dochoacruz/Proyecto-G2-EDP-R5053-2025/Proyecto 1C/Informe-IEEE.docx

Fuente Regulada Buck

Ochoa Cruz David¹, Calero Costa Diego Andrés²

Facultad Regional Buenos Aires, Universidad Tecnológica Nacional

¹Dochoacruz@frba.utn.edu.ar

²diegocale@frba.utn.edu.ar

Grupo 2

Abstract— En el marco de la asignatura Electrónica de Potencia, este proyecto se centra en el desarrollo completo de una fuente conmutada tipo Buck (reductor), orientada a convertir una tensión continua de entrada de 12V a una salida regulada de 5V. El diseño se basó en el uso del circuito integrado MC34063A, un controlador clásico por su simpleza, bajo costo y facilidad de implementación. A lo largo del trabajo se combinaron aspectos teóricos y prácticos, desde el análisis del funcionamiento de la topología Buck y el cálculo de los componentes claves (Inductor, Capacitor, Diodo, y resistencias), hasta la simulación del circuito en LTSpice para Evaluar su desempeño.

Posteriormente, se llevó a cabo el diseño del esquemático y del PCB utilizando herramienta CAD (KiCad), seguido de la construcción de un prototipo funcional que permitió comprobar el comportamiento real del sistema. Las pruebas experimentales permitieron validar la regulación de la tensión de salida y el correcto funcionamiento del regulador bajo distintas condiciones de carga.

En conclusión, el proyecto demuestra que es posible diseñar una fuente conmutada compacta, eficiente y confiable con recursos accesibles, integrando herramientas de simulación y diseño para lograr resultados consistentes entre la teoría y la práctica.

Palabras claves: Buck, MC34063A, conmutada, fuente conmutada. diseño

I. Introduction

En la actualidad, la eficiencia energética y la miniaturización de dispositivos electrónicos han impulsado el uso generalizado de las fuentes de alimentación conmutadas (Switch Mode Power Supplies) en una gama de aplicaciones, desde cargadores de dispositivos móviles hasta sistemas industriales y de telecomunicaciones. A diferencia de las fuentes lineales, que regulan la tensión mediante la disipación de potencia en elementos resistivos o activos que trabajan en la zona activa, las fuentes conmutadas utilizan llaves electrónicas de conmutación, como transistores, que trabajan en la zona de corte y saturación, disipando la mínima potencia, por lo que son muy eficientes.

Estas fuentes funcionan mediante la conmutación rápida de un interruptor electrónico (MOSFET, IGBT, etc.) que controlan el flujo de energía a través de componentes reactivos como inductores y capacitores, permitiendo almacenar y transferir energía de forma controlada. Esto los hace mucho más eficientes, logrando obtener fuentes de alimentación compactas, ligeras.

Existen diversas topologías de fuentes conmutadas, como los reguladores: Buck (reductor), Boost (elevador), Buck-Boost e incluso diseños más complejos como los convertidores Flyback y Forward, cada uno con sus propias ventajas.

El presente trabajo tiene como objetivo el diseño y desarrollo de una fuente conmutada tipo Buck, partiendo del análisis teórico y el cálculo de sus componentes, seguido de la simulación del circuito para validar su comportamiento. Posteriormente, se llevará a cabo la implementación física del prototipo, contrastando los resultados experimentales con los obtenidos en la etapa de simulación y diseño, con el fin de verificar el correcto funcionamiento y desempeño de la fuente.

II. Principio de funcionamiento

El regulador Buck es una topología de fuente conmutada reductora, es decir, a partir de una tensión de entrada, se obtiene un nivel de tensión inferior. Su funcionamiento se basa en el almacenamiento de energía en elementos reactivos, mediante un interruptor electrónico (generalmente un MOSFET), un diodo, un inductor y un capacitor, que juntos conforma un circuito de conversión reductor.

:

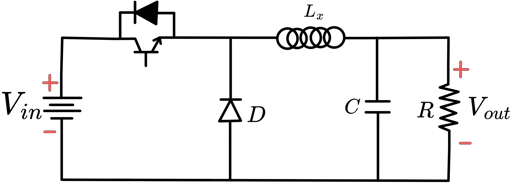
[picture p3: figure]

El principio de funcionamiento se puede dividir en dos fases diferentes durante un ciclo de conmutación completa:

ON (Interruptor cerrado): Cuando el interruptor está cerrado, el inductor comienza a almacenar energía en forma de campo magnético, mientras que la corriente aumenta linealmente. Durante este tiempo el diodo se encuentra polarizado en inversa (bloqueado). Inicialmente el capacitor es quién se encarga de entregar toda la corriente a la carga. Sin embargo, a medida que la corriente en el inductor incrementa, este empieza también a entregar corriente a la carga, compartiendo gradualmente la demanda con el capacitor hasta convertirse en la fuente principal de corriente durante esta fase.

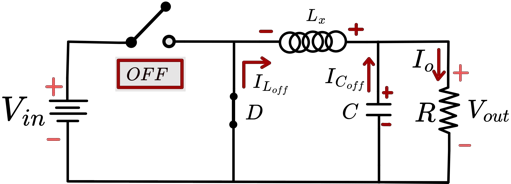
[picture p4: figure]

OFF (Interruptor abierto): Cuando el interruptor está se abre, el inductor se opone al cambio abrupto de la corriente, invirtiendo su polaridad. Esta corriente ahora fluye a través del diodo, que queda polarizado en directa, hacia la carga y el capacitor, manteniendo la entrega de energía. En esta fase, la corriente a través del inductor disminuye progresivamente. Para mantener la corriente constante en la carga, el capacitor es quién gradualmente repone lo que dejo de entregar el inductor, hasta que se convierte en la fuente principal de corriente durante esta fase.

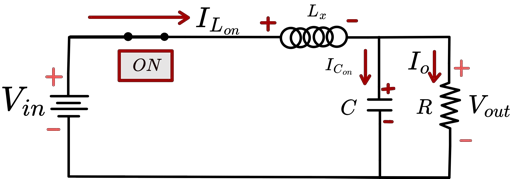
[picture p5: figure]

Este ciclo se repite a una frecuencia de conmutación f (típicamente entre las decenas de kHz hasta varios MHz), generando una tensión de salida regulada inferior a la entrada. La relación entre la tensión de entrada () y la tensión de salida () depende del ciclo de trabajo del interruptor, y en condiciones ideales se cumple que:

Donde es el ciclo de trabajo, definido como el cociente entre el tiempo en conducción y el periodo total del ciclo de conmutación.

III. Diseño teórico.
  A. Especificaciones de diseño

Parámetro | Símbolo | Valor | Unidad
Tension de Entrada | | 12 | V
Tension de Salida | | 5 | V
Corriente de Salida | | 0.2 – 1.0 | A
Frecuencia de conmutación | | 40 | kHz
Rizado de tension | | | mV

  B. Características principales del mc34063A

Parámetro | Símbolo | Valor | Unidad
Tensión de Entrada | | 12 | V
Tensión de Salida | | 5 | V
Corriente de Salida | | 0.2 – 1.0 | A
Frecuencia de conmutación | | 40 | kHz
Rizado de tensión | | | mV

  C. Ecuaciones fundamentales de diseño

Descripción | Step Dow
Razón de tiempos
Periodo
Tiempo de Apagado
Tiempo de Encendido
Capacidad de Timing
Corriente Pico
Resistencia de Sencing
Inductancia mínima
Capacidad de Salida
Tensión de Salida

  D. DISEÑÓ PROPUESTO

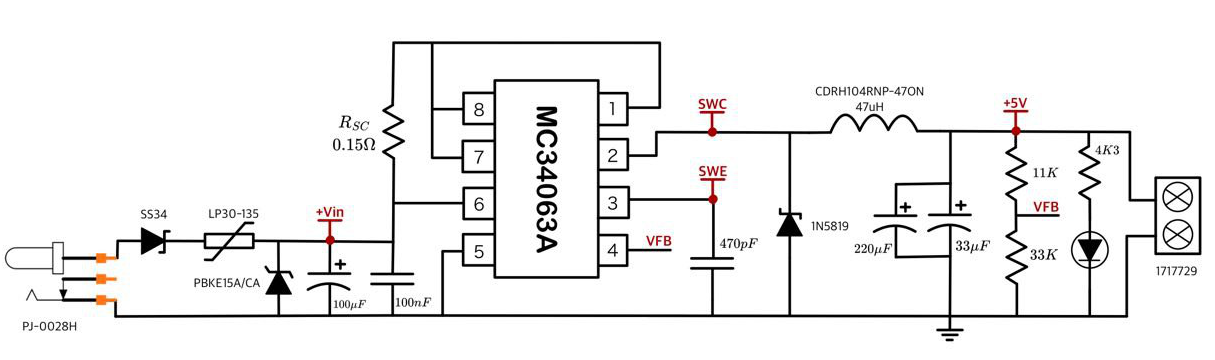
[picture p6: figure]

IV. Simulaciones

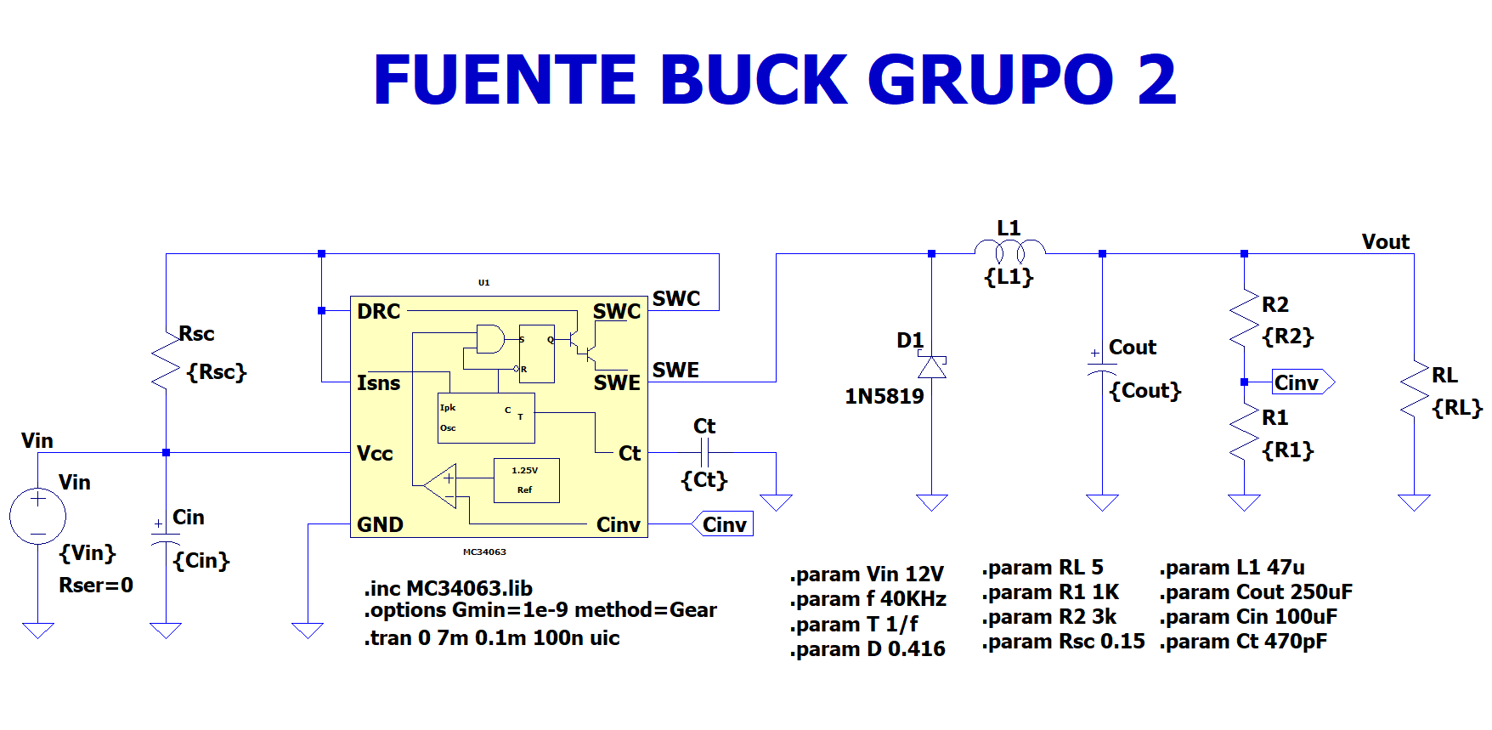
[picture p7: figure]
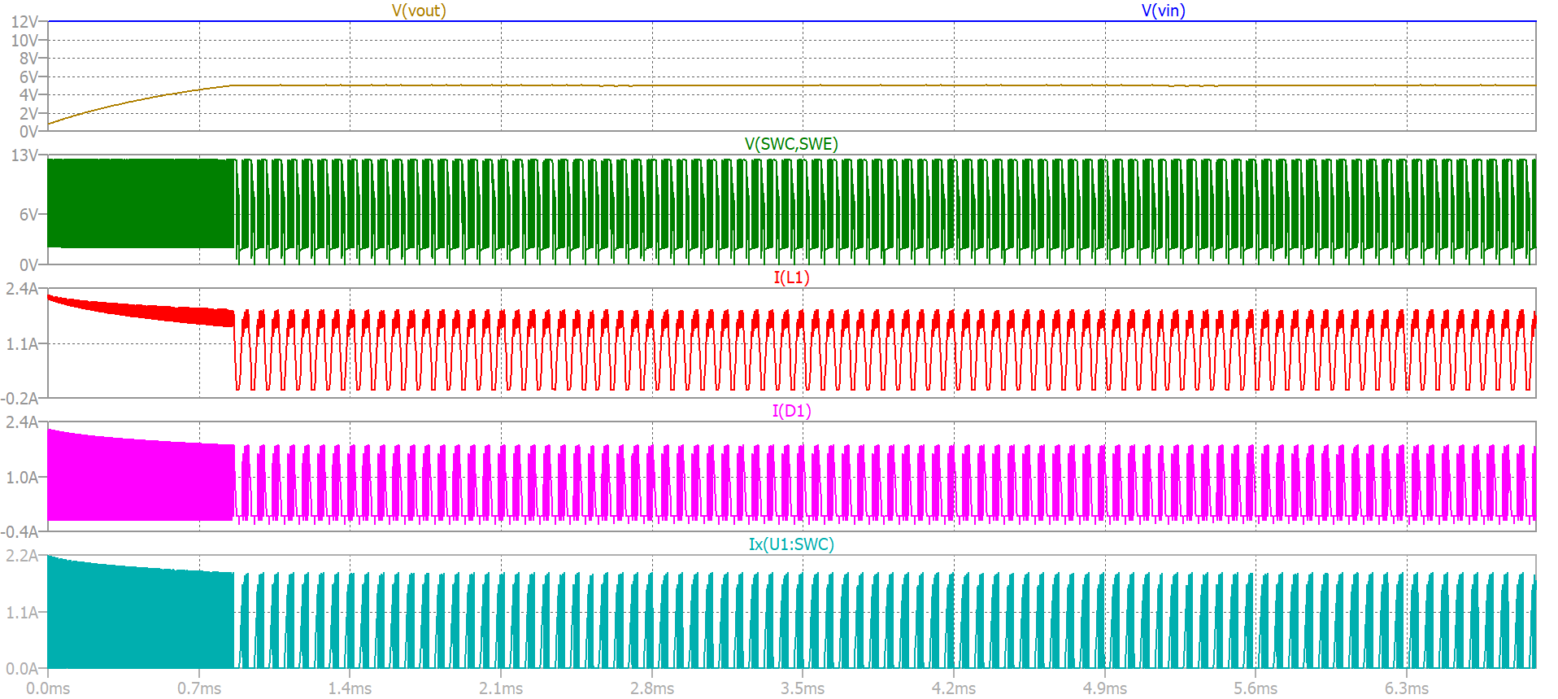
[picture p8: figure]

V. Mediciones de laboratorio
  A. CONDICIONES DE MEDICIÓN

Parámetro | Símbolo | Valor
Tensión de Alimentación
Resistencia de Carga

  B. INSTRUMENTTOS UTILIZADOS
- Fuente DC
- Osciloscopio
- Multímetro
  C. RESULTADOS DE LA MEDICIÓN

Parámetro | Símbolo | Valor
Tensión de Salida
Corriente de Salida
Ripple de Salida

VI. Conclusión

La realización de este proyecto resulto altamente didáctica, ya que permitió integrar y aplicar de manera efectiva los conocimientos teóricos y prácticos abordados en la cursada. Esto se vio reflejado especialmente en las pruebas experimentales, donde los resultados obtenidos fueron incluso mejores de lo esperado.

Durante el desarrollo se identificó la posibilidad de incorporar elementos de protección (como un poliswith y/o un diodo TVS), los cuales no se implementaron por cuestiones de tiempo. Siendo estas, mejoras para tener en cuenta en futuras versiones del proyecto.

Asimismo, el trabajo en equipo fue clave para alcanzar los objetivos, con una correcta división de tareas y colaboración constante entre los integrantes.

En definitiva, el proyecto no solo permitió cumplir con los objetivos académicos propuestos, sino que también despertó interés por seguir diseñando otras topologías de fuentes conmutadas, aplicando el mismo enfoque sistemático de análisis, diseño, simulación e implementación.

Referencias

[1] Hoja de datos del integrado: MC34063A - Inverting Regulator - Buck, Boost, Switching 1.5 A (https://www.onsemi.com/pdf/datasheet/mc34063a-d.pdf)
[2] Repositorio GitHub: Proyecto-G2-EDP-R5053-2025 (https://github.com/dochoacruz/Proyecto-G2-EDP-R5053-2025/blob/main/Proyecto%201C/Jupyter%20Notebook/Proyecto-G2.ipynb)
[3] Informe en formato cuaderno: Jupyter Notebook Viewer (https://nbviewer.org/github/dochoacruz/Proyecto-G2-EDP-R5053-2025/blob/main/Proyecto%201C/Jupyter%20Notebook/Proyecto-G2.ipynb)

[4] Video demostrativo: https://www.youtube.com/embed/OiL7ilHiBNU
