dochoacruz/Proyecto-G2-EDP-R5053-2025/Proyecto 1C/Informe.docx

UNIVERSIDAD TECNOLÓGICA NACIONAL FACULTAD REGIONAL BUENOS AIRES

Departamento de Electrónica

Fuente Regulada Buck

Materia: | Electrónica de Potencia
Curso: | R5052 - 2025
Docente: | Ing. Oscar Pugliese
Ayudante: | Diego Pirotta
Integrantes:

APELLIDO | NOMBRE | LEGAJO
Calero Costa | Diego | 1526066
Ochoa Cruz | David | 1638518

ÍNDICE

DICE

ABSTRACT

As part of the Power Electronics course, this project focused on the development of a Buck-type switched-mode power supply (step-down converter), designed to convert a 12V input voltage into a regulated 5V output. The design was based on the MC34063A integrated circuit, a widely used controller due to its simplicity, low cost, and ease of implementation.

The project encompassed both theoretical and practical aspects, including an analysis of the Buck converter's operating principle and the calculation of key components—inductor, capacitor, diode, and resistors—as well as circuit simulation using LTSpice to verify the theoretical results.

Subsequently, the schematic and printed circuit board (PCB) were designed using the KiCad CAD tool, followed by the construction of a functional prototype to assess the system’s real-world performance. Experimental measurements carried out with laboratory instruments validated the output voltage regulation and confirmed the proper operation of the converter under maximum load conditions.

In conclusion, the objectives defined at the outset of the project were successfully achieved, demonstrating the effective integration of the theoretical knowledge and practical skills developed throughout the course.

Keywords: Buck, MC34063A, switching, switching power supply, design.

RESUMEN

En el marco de la asignatura de Electrónica de Potencia, este proyecto se enfocó en el desarrollo de una fuente conmutada tipo Buck (reductor), con el objetivo de convertir una tensión de entrada de 12V, a una salida regulada de 5V. El diseño se basó en el uso del circuito integrado MC34063A, un controlador ampliamente utilizado por su simplicidad, bajo costo y facilidad de implementación.

A lo largo del trabajo se trataron tanto aspectos teóricos como prácticos: desde el análisis del principio de funcionamiento de la topología Buck y el cálculo de los componentes claves (Inductor, Capacitor, Diodo, y resistencias), hasta la simulación del circuito en LTSpice con el fin de validar los resultados obtenidos en los cálculos previos.

Posteriormente, se llevó a cabo el diseño del esquemático y del PCB utilizando herramienta CAD (KiCad), y se construyó un prototipo funcional que permitió comprobar el comportamiento real del sistema. Las mediciones con los instrumentos de laboratorio permitieron validar la regulación de la tensión de salida y el correcto funcionamiento del regulador bajo condición de máxima carga.

En conclusión, tras cumplir con los objetivos planteados al inicio del presente proyecto, se logró integrar de forma satisfactoria los contenidos abordados durante la cursada.

Palabras claves: Buck, MC34063A, conmutada, fuente conmutada. diseño

# I. INTRODUCCIÓN

En la actualidad, la eficiencia energética y la miniaturización de dispositivos electrónicos impulsaron el uso generalizado de las fuentes de alimentación conmutadas (Switch Mode Power Supplies) en una gama de aplicaciones, desde cargadores de dispositivos móviles hasta sistemas industriales y de telecomunicaciones. A diferencia de las fuentes lineales, que regulan la tensión mediante la disipación de potencia en elementos resistivos o activos que trabajan en la zona activa, las fuentes conmutadas utilizan llaves electrónicas de conmutación, como transistores, que trabajan en la zona de corte y saturación, disipando la mínima potencia, por lo que son muy eficientes.

Estas fuentes funcionan mediante la conmutación rápida de un interruptor electrónico (MOSFET, IGBT, etc.) que controlan el flujo de energía a través de componentes reactivos como inductores y capacitores, permitiendo almacenar y transferir energía de forma controlada. Esto los hace mucho más eficientes, logrando obtener fuentes de alimentación compactas y ligeras.

Existen diversas topologías de fuentes conmutadas, como los reguladores: Buck (reductor), Boost (elevador), Buck-Boost e incluso diseños más complejos como los convertidores Flyback y Forward, cada uno con sus propias ventajas.

El presente trabajo tiene como objetivo el diseño y desarrollo de una fuente conmutada tipo Buck, partiendo del análisis teórico y el cálculo de sus componentes, seguido de la simulación del circuito para validar su comportamiento. Posteriormente, se llevará a cabo la implementación física del prototipo, contrastando los resultados experimentales con los obtenidos en la etapa de simulación y diseño, con el fin de verificar el correcto funcionamiento y desempeño de la fuente.

# II. PRINCIPIO DE FUNCINAMIENTO

El regulador Buck es una topología de fuente conmutada reductora, es decir, a partir de una tensión de entrada, se obtiene un nivel de tensión inferior. Su funcionamiento se basa en el almacenamiento de energía en elementos reactivos, mediante un interruptor electrónico (generalmente un MOSFET), un diodo, un inductor y un capacitor, que juntos conforman un circuito de conversión reductor.

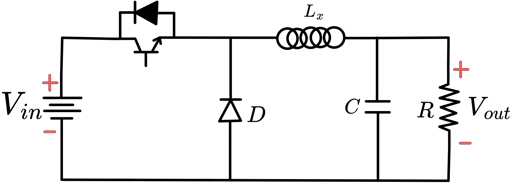
[picture p9: figure]

Fig. 1: Fuente Buck

El principio de funcionamiento se puede dividir en dos etapas diferentes durante un ciclo de conmutación completa:

- ON (Interruptor cerrado): Cuando el interruptor está cerrado, el inductor comienza a almacenar energía en forma de campo magnético, mientras que la corriente aumenta linealmente. Durante este tiempo el diodo se encuentra polarizado en inversa (bloqueado). Inicialmente el capacitor es quién se encarga de entregar toda la corriente a la carga. Sin embargo, a medida que la corriente en el inductor incrementa, este empieza también a entregar corriente a la carga, compartiendo gradualmente la demanda con el capacitor hasta convertirse en la fuente principal de corriente durante esta etapa.


Fig. 2: Interruptor Cerrado

- OFF (Interruptor abierto): Cuando el interruptor se abre, el inductor se opone al cambio abrupto de la corriente, invirtiendo su polaridad. Esta corriente ahora fluye a través del diodo y hacia la carga y el capacitor, manteniendo la entrega de energía. En esta etapa, la corriente a través del inductor disminuye progresivamente. Para mantener la corriente constante en la carga, el capacitor es quién gradualmente repone lo que dejo de entregar el inductor, hasta que se convierte en la fuente principal de corriente durante hasta finalizar el ciclo de conmutación.


Fig. 3: Interruptor abierto

Este ciclo se repite a una frecuencia de conmutación f (típicamente entre las decenas de kHz hasta varios MHz), generando una tensión de salida regulada inferior a la entrada. La relación entre la tensión de entrada ( V_(in) ) y la tensión de salida ( V_(out) ) depende del ciclo de trabajo D del interruptor, y en condiciones ideales se cumple que:

V_(out) =D∙V_(in)

Donde D es el ciclo de trabajo, definido como el cociente entre el tiempo en conducción t_(on) y el periodo total T del ciclo de conmutación.

# III. DISEÑO TEÓRICO

## III.1 Especificaciones de Diseño

Parámetro | Símbolo | Valor | Unidad
Tensión de Entrada | V_(in) | 12 | V
Tensión de Salida | V_(out) | 5 | V
Corriente de Salida | I_(out) | 0.2 – 1.0 | A
Frecuencia de conmutación | f_s | 40 | kHz
Rizado de tensión | ΔV_(out) | ≤25 | mV

## III.2 Características Principales del MC34063A

Parámetro | Símbolo | Valor
Rango de Tensión de entrada | V_(in) | 3V a 40V
Corriente máxima de Salida | I_(out) | 1.5A
Frecuencia de Oscilación | f_s | 25→100 KHz
Tensión de referencia interna | V_(REF) | 1.25V ±2%
Tensión de saturación | V_(CE(sat)) | 1V

## III.3 Ecuaciones fundamentales de Diseño

Descripción | Step Dow
Razón de tiempos | (t_(on))/(t_(off))=(V_(out) +V_F)/(V_(in) -V_(out) -V_(sat))
Periodo | T=1/f
Tiempo de Apagado | t_(off) =T/((t_(on))/(t_(off))+1)
Tiempo de Encendido | t_(on) =T-t_(off)
Capacidad de Timing | C_T =4×10^(-5) ∙t_(on)
Corriente Pico | I_(pk(switch)) =2∙I_(out(máx))
Resistencia de Sencing | R_(SC) =0.3/(I_(pk(switch)))
Inductancia mínima | L_(mín) =((V_(in) -V_(sat) -V_(out))/(I_(pk(switch))))∙t_(on)
Capacidad de Salida | C_o =(I_(pk(switch)) (t_(on) +t_(off) ))/(8∙ΔV_(out))
Tensión de Salida | V_(out) =V_(REF) (1+(R_2)/(R_1))

## III.4 Circuito Propuesto

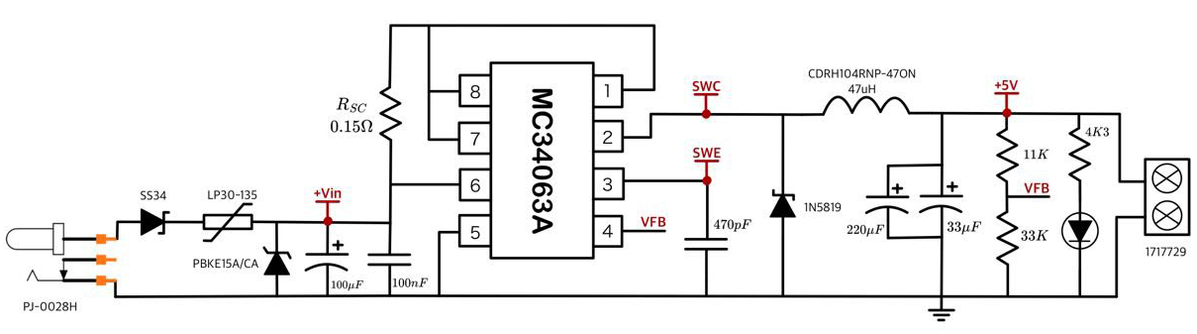
[picture p10: figure]

Fig. 4: Circuito propuesto

## III.5 Cálculo Teórico

Cálculo de los tiempos de Conmutación

(t_(on))/(t_(off))=(V_(out) +V_F)/(V_(in) +V_(sat) -V_(out))=(5V+0.5V)/(12V-1V-5V)=0.917

T=1/f=1/(40kHz)=25μs

t_(off) =T/(((t_(on))/(t_(off))+1))=(25μs)/(0.917+1)=13.04μs

t_(on) =T-t_(off) =25μs-13.04μs= 11.96μs

Cálculo del capacitor de Timing (C_T )

C_T =4×10^(-5) ∙t_(on) =4×10^(-5) ∙ 11.96μs=47.84×10^(-11) F

C_T =478.4 pF (Valor exacto)

C_(T_C) ≈470 pF (Valor comercial)

Verificación del tiempo de encendido

t_(on(real)) =(C_(T_C))/(4×10^(-5))=(470×10^(-12))/(4×10^(-5))=11.75μs

Δt_(on) =11.96μs-11.75μs=0.21μs (Diferencia despreciable)

Cálculo de la Corriente Pico del Switch (I_(pk(switch)) )

I_(pk) =2×I_(out(máx)) =2×1A=2A

Cálculo de Resistor de Sensing (R_(SC) )

R_(SC) =0.3/(I_(pk))=0.3/(2A)=0.15Ω

P_(R_(SC)) =I_(pk)^2 ×R_(SC) =(2A)^2 ∙ 0.15Ω=0.6W

R_(SC_C) =0.15Ω-1W (Valore comercial)

Cálculo de la inductancia mínima (L_(mín) )

L_(mín) =((V_(in) -V_(sat) -V_(out))/(I_(pk)))×t_(on) =((12V-1V-5V)/(2A))×11.96μs=35.88μH

L=47μH (Valor comercial seleccionado)

Corriente máxima en el inductor (L)

I_(L_(avg)) =I_(out(máx)) =1A

ΔI_L =((V_(in) -V_(sat) -V_(out) )∙t_(on))/L=((12V-1V-5V)∙11.96μs)/(47μH)=1.53A

I_(L(máx)) =I_(L_(avg)) +(ΔI_L)/2=1A+(1.53A)/2=1.765 A

El inductor debe tener una corriente de saturación mayor a 1.765A (I_(L_(sat)) =2A)

Cálculo del Capacitor de Salida (C_O )

C_O =(I_(pk) (t_(on) +t_(off) ))/(8ΔV_(ripple))=(2A×25μs)/(8×0.025V)=250μF

C_o =220uF+33μF (Valores comreciales seleccionados)

Cálculo de la Tensión de Salida (V_(out) )

V_(out) =V_(REF) ×(1+(R_2)/(R_1))=5V

Cálculo de la relación de resistencias

(R_2)/(R_1)=(V_(out))/(V_(REF))-1=(5V)/(1.25V)-1=3

Valores comerciales sugeridos

R_1 =11KΩ, R_2 =33KΩ

## III.6 Componentes Calculados

Componentes | Valor Calculado | Valor Comercial | Especificaciones
C_T (Timing) | 478.4 pF | 470 pF | Cerámico NPO
R_(SC) | 0.15 Ω | 0.15Ω | 1W, ±1%
L (Inductor) | 35.88 μH | 47 μH | 2 A (I_(sat) )
C_O (output) | 250 μF | 220+33 μF | Low ESR
C_i (in) | 100 nF | 100 nF | Low ESR
R_1 / R_2 | Ratio 3:1 | 1kΩ/2kΩ | ±1%, 1/4W

## III.7 Verificación de Cálculos con Python

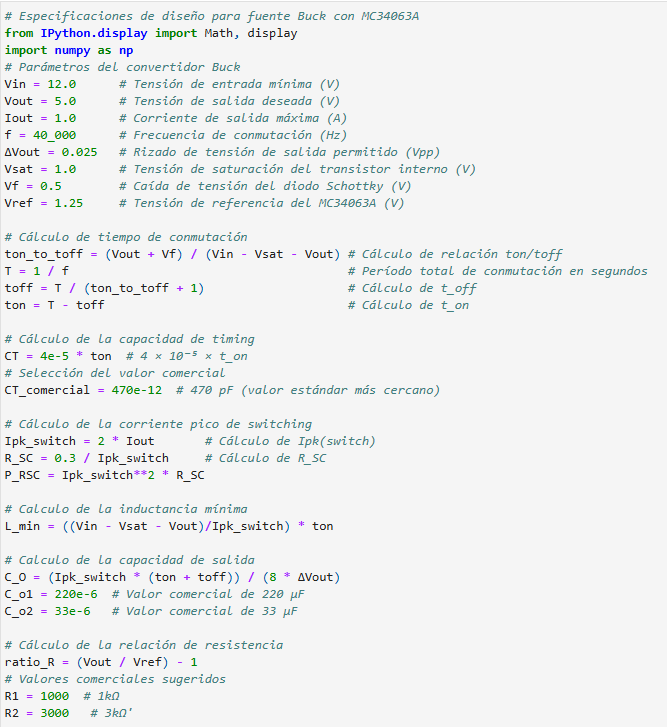
[picture p11: figure]
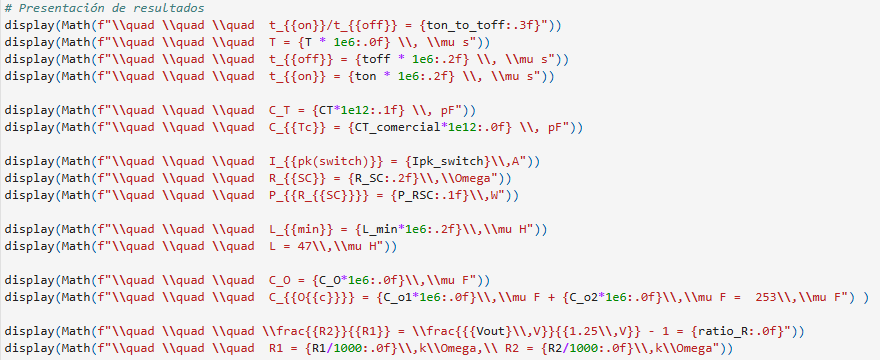
[picture p12: figure]

Resultados obtenidos:

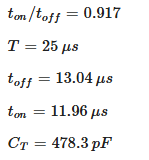
[picture p13: figure]
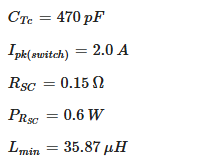
[picture p14: figure]
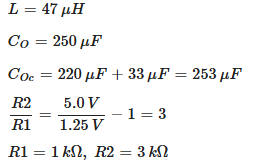
[picture p15: figure]

# IV. SIMULACIONES EN LTspice


Fig. 5: Diagrama de circuito


Fig. 6 Grafico: 1) Tensión de salida y entrada. 2) Tensión de Switching. 3) Corriente en el inductor. 4) Corriente en el Diodo. 5) Corriente en el Switching.

# V. IMPLEMENTACIÓN PRÁCTICA

## V.1 Esquemático

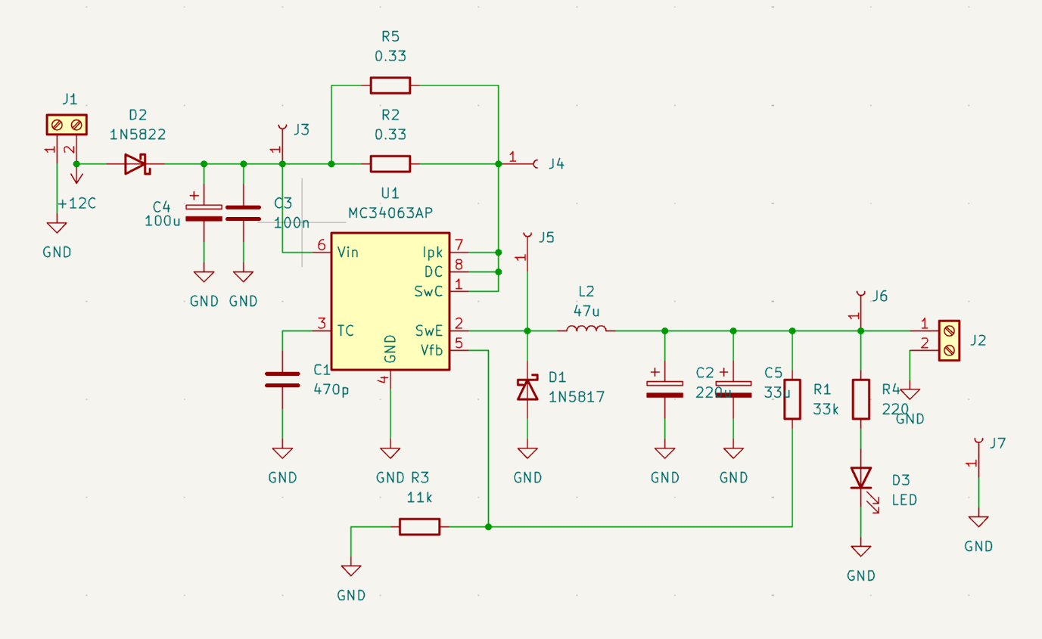
[picture p16: figure]

Fig. 7: Esquemático realizado en KiCad

## V.2 PCB

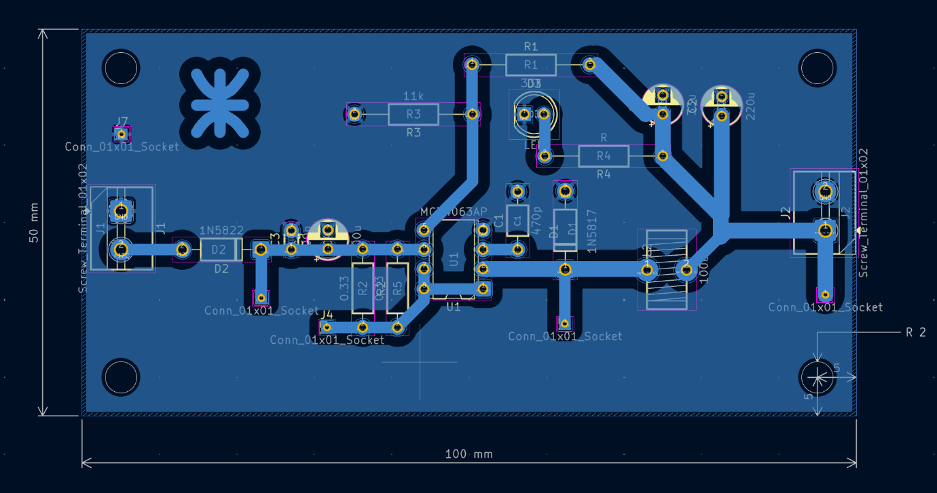
[picture p17: figure]

Fig. 8: PCB realizado en KiCad

## V.3 Diseño 3D

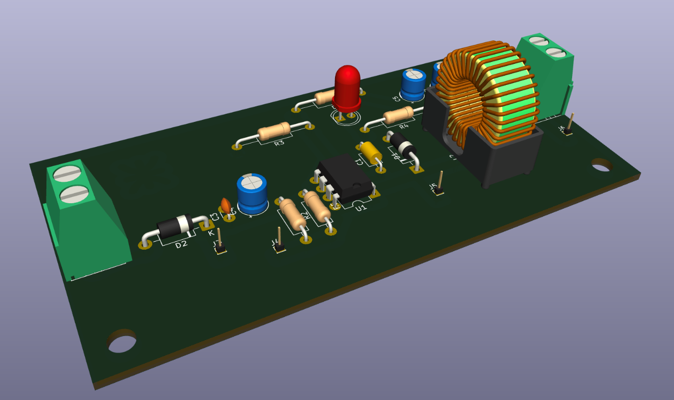
[picture p18: figure]

Fig. 9: imagen en 3d del PCB

## V.4 Diseño Final

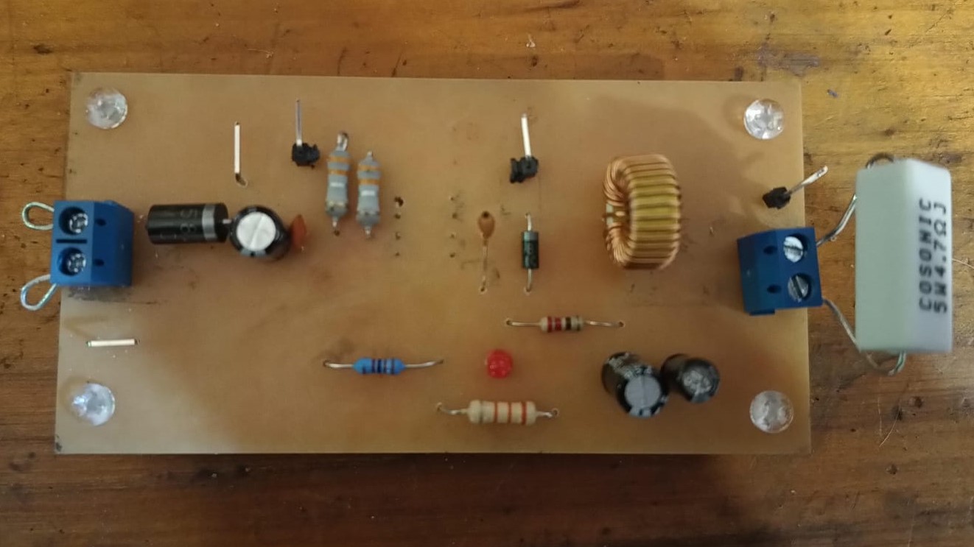
[picture p19: figure]

Fig. 10: Diseño físico

# VI. MEDICIONES DE LABORATORIO

## VI.1 Condiciones de la medición

Parámetro | Símbolo | Valor
Tensión de Alimentación | V_(in) | 11.9V
Resistencia de Carga | R_L | 4.7Ω

## VI.2 Instrumentos utilizados para la medición:

    - Fuente DC
    - Osciloscopio
    - Multímetro

## VI.3 Resultados de la medición:

Parámetro | Símbolo | Valor
Tensión de Salida | V_(out) | 4.99V
Corriente de Salida | I_(out) | 1.062 A
Ripple de Salida | ΔV_(out) | 60mV

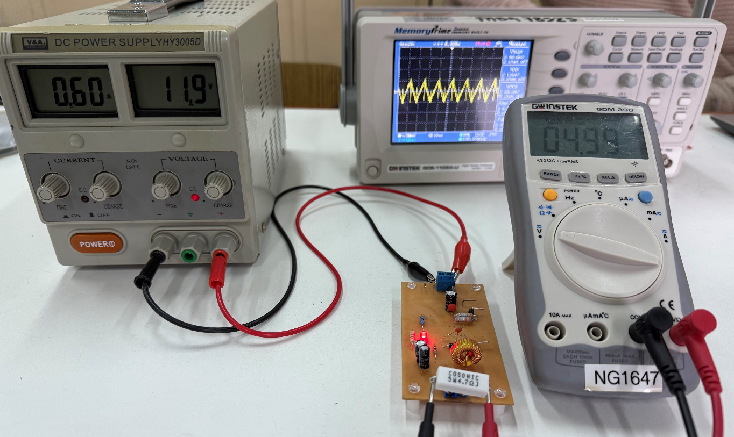
[picture p20: figure]

Fig. 11: Mediciones realizadas en el laboratorio

# VII. CONCLUCIÓN

La realización de este proyecto resulto altamente didáctica, ya que permitió integrar y aplicar de manera efectiva los conocimientos teóricos y prácticos abordados en la cursada. Esto se vio reflejado especialmente en las pruebas experimentales, donde los resultados obtenidos fueron incluso mejores de lo esperado.

Durante el desarrollo se identificó la posibilidad de incorporar elementos de protección (como un poliswith y/o un diodo TVS), los cuales no se implementaron por cuestiones de tiempo. Siendo estas, mejoras para tener en cuenta en futuras versiones del proyecto.

Asimismo, el trabajo en equipo fue clave para alcanzar los objetivos, con una correcta división de tareas y colaboración constante entre los integrantes.

En definitiva, el proyecto no solo permitió cumplir con los objetivos académicos propuestos, sino que también despertó interés por seguir diseñando otras topologías de fuentes conmutadas, aplicando el mismo enfoque sistemático de análisis, diseño, simulación e implementación.

# VIII. REFERENCIAS

- Hoja de datos del integrado: MC34063A - Inverting Regulator - Buck, Boost, Switching 1.5 A (https://www.onsemi.com/pdf/datasheet/mc34063a-d.pdf)
- Repositorio GitHub: Proyecto-G2-EDP-R5053-2025 (https://github.com/dochoacruz/Proyecto-G2-EDP-R5053-2025/blob/main/Proyecto%201C/Jupyter%20Notebook/Proyecto-G2.ipynb)
- Informe en formato cuaderno: Jupyter Notebook Viewer (https://nbviewer.org/github/dochoacruz/Proyecto-G2-EDP-R5053-2025/blob/main/Proyecto%201C/Jupyter%20Notebook/Proyecto-G2.ipynb)
- Video demostrativo: https://www.youtube.com/embed/OiL7ilHiBNU

Universidad Tecnológica Nacional – Facultada Regional Buenos Aires Departamento de Ingeniería Electrónica 2 de 4

Universidad Tecnológica Nacional – Facultada Regional Buenos Aires Departamento de Ingeniería Electrónica - 2025

ELECTRÓNICA DE POTENCIA - R5052 Proyecto 1°C - 2025 Grupo 2
