dochoacruz/Proyecto-G2-EDP-R5053-2025/Proyecto 1C/IMG/Portada de Video.jpg

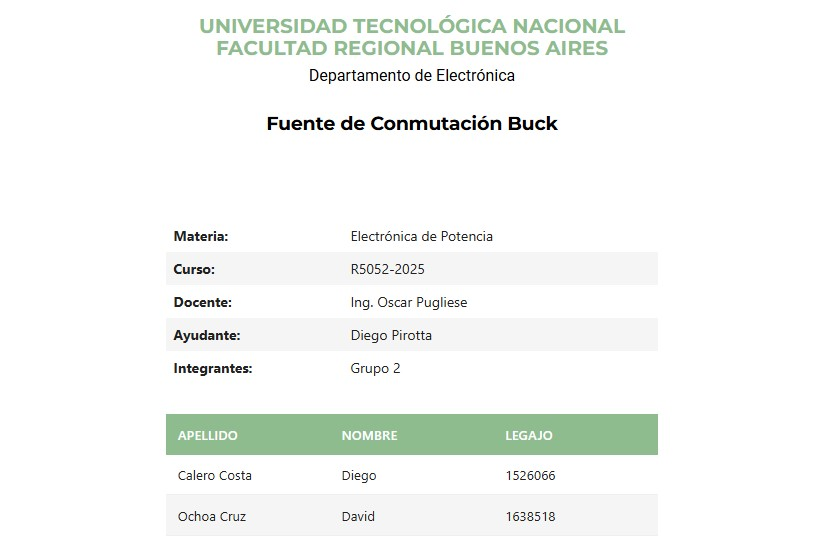
Proyecto 1C/IMG/Portada de Video.jpg
