dochoacruz/Proyecto-G2-EDP-R5053-2025/Proyecto 1C/Jupyter Notebook/IMG/G2-gráficoV2.png

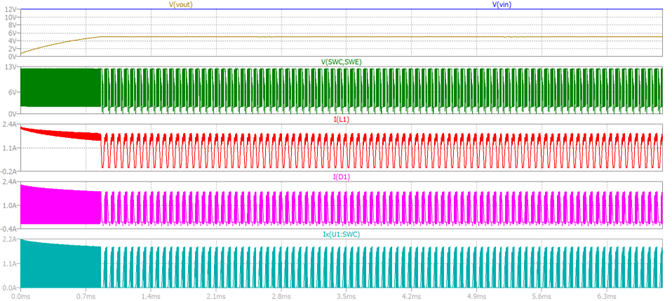
Proyecto 1C/Jupyter Notebook/IMG/G2-gráficoV2.png
