dochoacruz/Proyecto-G2-EDP-R5053-2025/Proyecto 1C/Jupyter Notebook/IMG/PCB.jpg

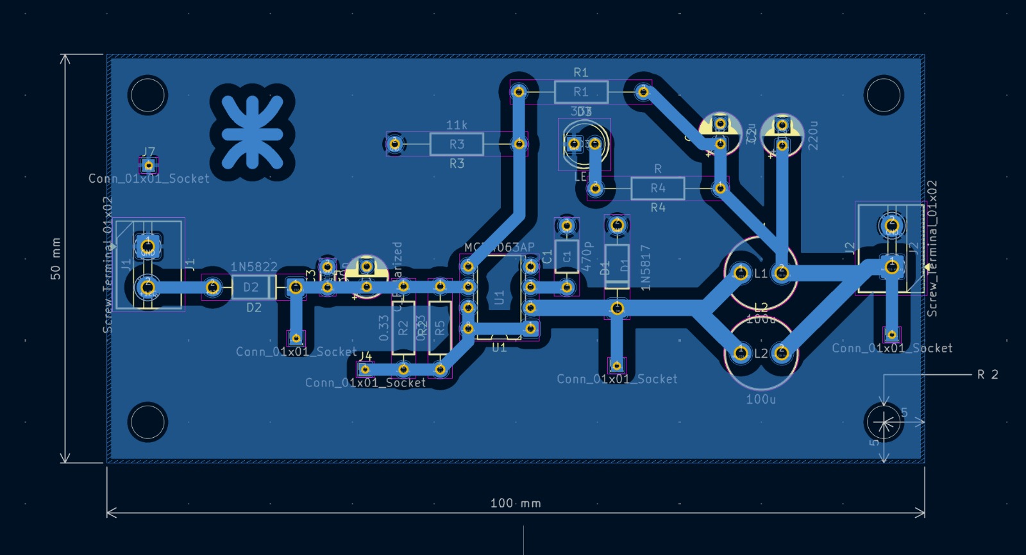
Proyecto 1C/Jupyter Notebook/IMG/PCB.jpg
