dochoacruz/Proyecto-G2-EDP-R5053-2025/Proyecto 1C/LTSpice/G2-circuito.jpg

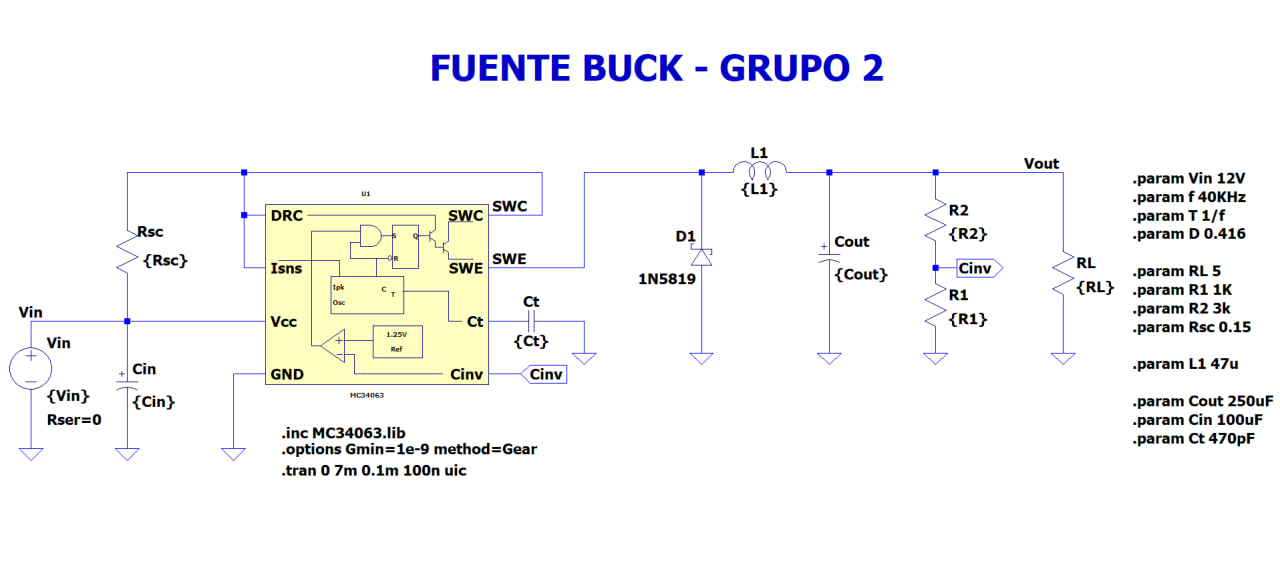
Proyecto 1C/LTSpice/G2-circuito.jpg
