dochoacruz/Proyecto-G2-EDP-R5053-2025/Proyecto 1C/Varios/Componentes de Protección.docx

Inductor: CDRH104RNP-47ØN

- Inductancia: 47μH ±30%
- Resistencia (DCR): 128mΩ máximo
- Corriente de Saturación (2.1A)

Diodo de inversión de polaridad: SS34 (Schottky 40V/3A)

- Corriente nominal I_f : 3A
- Tensión inversa (VRRM): 40V
- Caída de tensión en Directa V_f : 0.41V

Poliswitch: LP30-135

- Tensión máxima que soporta a Circuito abierto: 30V
- Corriente máxima que pude fluir antes de activarse IH: 1.35A
- Corriente mínima que garantiza su activación IT: 2.7A
- Tiempo máximo para activarse: 3.5s
- Corriente máxima que puede soportar sin destruirse Imáx: 40A
- Resistencia (Rmin/Rmax): 0.068 Ω/0.140Ω

Diodo TVS: PBKE15A/CA

- Tensión de Trabajo Reverso VRWM: 15V
- Tensión de Ruptura VBR: 16.7V
- Tensión de Clamping VC: 24.4V
- IPP: 1A

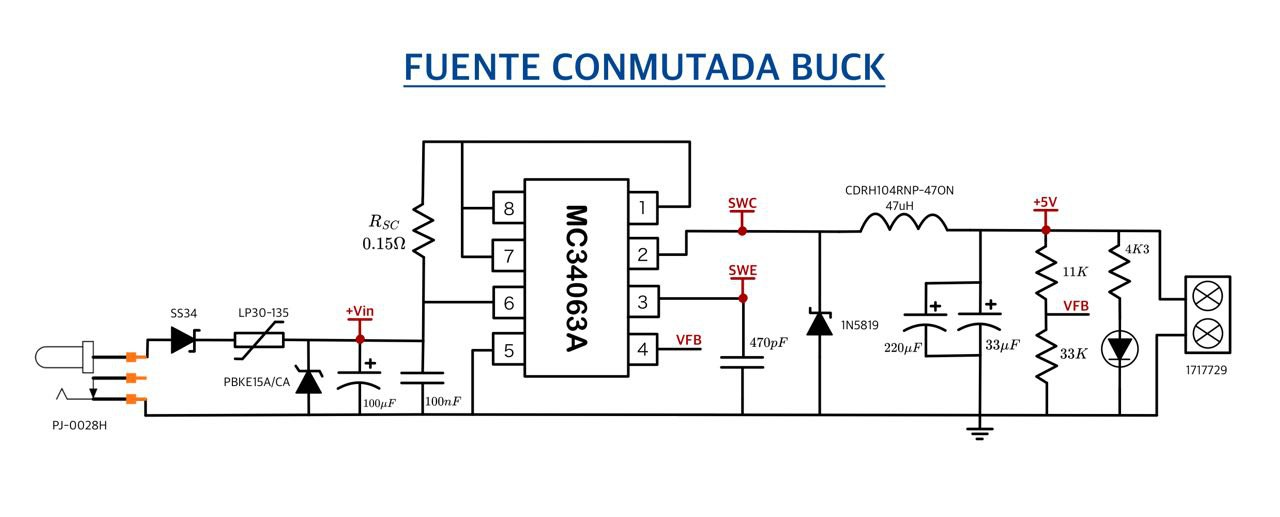
[picture p41: figure]
