dochoacruz/Proyecto-G2-EDP-R5053-2025/Proyecto 1C/Varios/Lista de Componentes.xlsx

Cantidad | Componente | Descripción | N° de Pieza | Encapsulado | Estado
1 | MC34063A | Switching Regulators | MC34063A | DIP8
1 | Inductor | Inductancia: 47μH ±30% Corriente de Saturación (2.1A) | CDRH104RNP-47O | SMD
1 | Diodo Schottky | Diodo de inversión de polaridad (Schottky 40V/3A) |  | DO-214AB
1 | Poliswitch | Protección Contra sobrecargas y cortocircuitos | LP30-135 | Axial (THT)
1 | Diodo TVS | Diodo Supresor De Transitorios De Tension | PBKE15A/CA | Axial Leaded
2 | Resistencia shunt | Resistencia shunt 0.15Ω/5Ω - 5W |  | Axial (THT)
1 | Diodo | Diodo de recuperación | 1N5819 | Axial (THT)
3 | Resistencia | Resistencias 11k, 33k, 4k3, 1/4W |  | Axial (THT)
1 | Didodo Led | Diodo led 5mm |  | DIODO-DIP
3 | Capacitor Electrolitico | Capacitor electrolitico 220uF, 33uF, 100uF |  | Radial (THT)
2 | Capacitor cerámico | Capacitor cerámico 470pF, 100nF |  | Axial (THT)
1 | Conector | Conector de fuente 12V DC | PJ-0028H
1 | Borenera | Borenera de salida | 1717729
1 | PCB | PCB Simple faz 5cm X 10cm
4 | Soporte pcb | Separador de pcb plástico
24
