dochoacruz/Proyecto-G2-EDP-R5053-2025/Proyecto 1C/Kicad/RAPC742X/3D/RAPC742X.stp

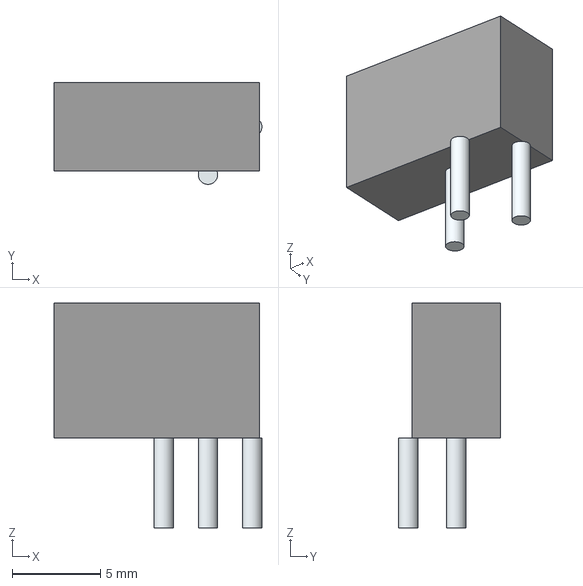
[picture p42: CAD file, 2025-07-03]
Proyecto 1C/Kicad/RAPC742X/3D/RAPC742X.stp
11.8 x 5.75 x 12.7 mm
Leads
