dochoacruz/Proyecto-G2-EDP-R5053-2025/(list of files, cad)

Other CAD files:
Proyecto 1C/Kicad/RAPC742X/Allegro/rapc742x.psm
Proyecto 1C/Kicad/RAPC742X/DEHDL/rapc742x/chips/chips.prt
