dochoacruz/Proyecto-G2-EDP-R5053-2025/Proyecto 1C/LTSpice/G2.asc

Cin: polcap; {Cin}
Cout: polcap; {Cout}
Ct: cap; {Ct}
D1: schottky; 1N5819
L1: ind; {L1}
R1: res; {R1}
R2: res; {R2}
RL: res; {RL}
Rsc: res; {Rsc}
U1: mc34063
Vin: voltage; {Vin}; Rser=0
Named nets: 0, Vout, SWC, Vin, SWE, Cinv
.inc MC34063.lib
.param L1 47u
.param Cout 250uF
.param Cin 100uF
.param Ct 470pF
.options Gmin=1e-9 method=Gear
.tran 0 7m 0.1m 100n uic
.param Vin 12V
.param f 40KHz
.param T 1/f
.param D 0.416
.param RL 5
.param R1 1K
.param R2 3k
.param Rsc 0.15
FUENTE BUCK GRUPO 2
