dochoacruz/Proyecto-G2-EDP-R5053-2025/(list of files, drawings)

Other design files:
Proyecto 1C/Kicad/RAPC742X/Altium/RAPC742X.PcbLib
Proyecto 1C/Kicad/RAPC742X/Altium/RAPC742X.SchLib
