dochoacruz/Proyecto-G2-EDP-R5053-2025/(commit log)

2025-06-08 iniciando el diseño
2025-06-08 cálculo del capacitor de timing
2025-06-08 Cambiando el color de los indices
2025-06-15 Links de ïndice corregido
2025-06-17 Completando link de referencia del índice
    [Lista de Componentes.xlsx]
2025-07-03 Subiendo imágnes de pcb y esquemático
    [BuckKicad.kicad_pcb, BuckKicad.kicad_sch, EDI2CAP.CFG, Lista de Componentes.xlsx, RAPC742X.PcbLib, RAPC742X.SchLib, RAPC742X.stp, chips.prt]
2025-07-06 subiendo video explicativo de funcionamiento
2025-07-10 Agregado de imágnes e informe completado
2025-07-10 corrigiendo errores de tabla
2025-07-10 Corrigiendo errores de imágenes
2025-07-10 link de jupyter corregido
